0x007E/dir/pcb/DIR.kicad_pcb

## KiCad design pcb/DIR.kicad_pcb (2026-03-28)

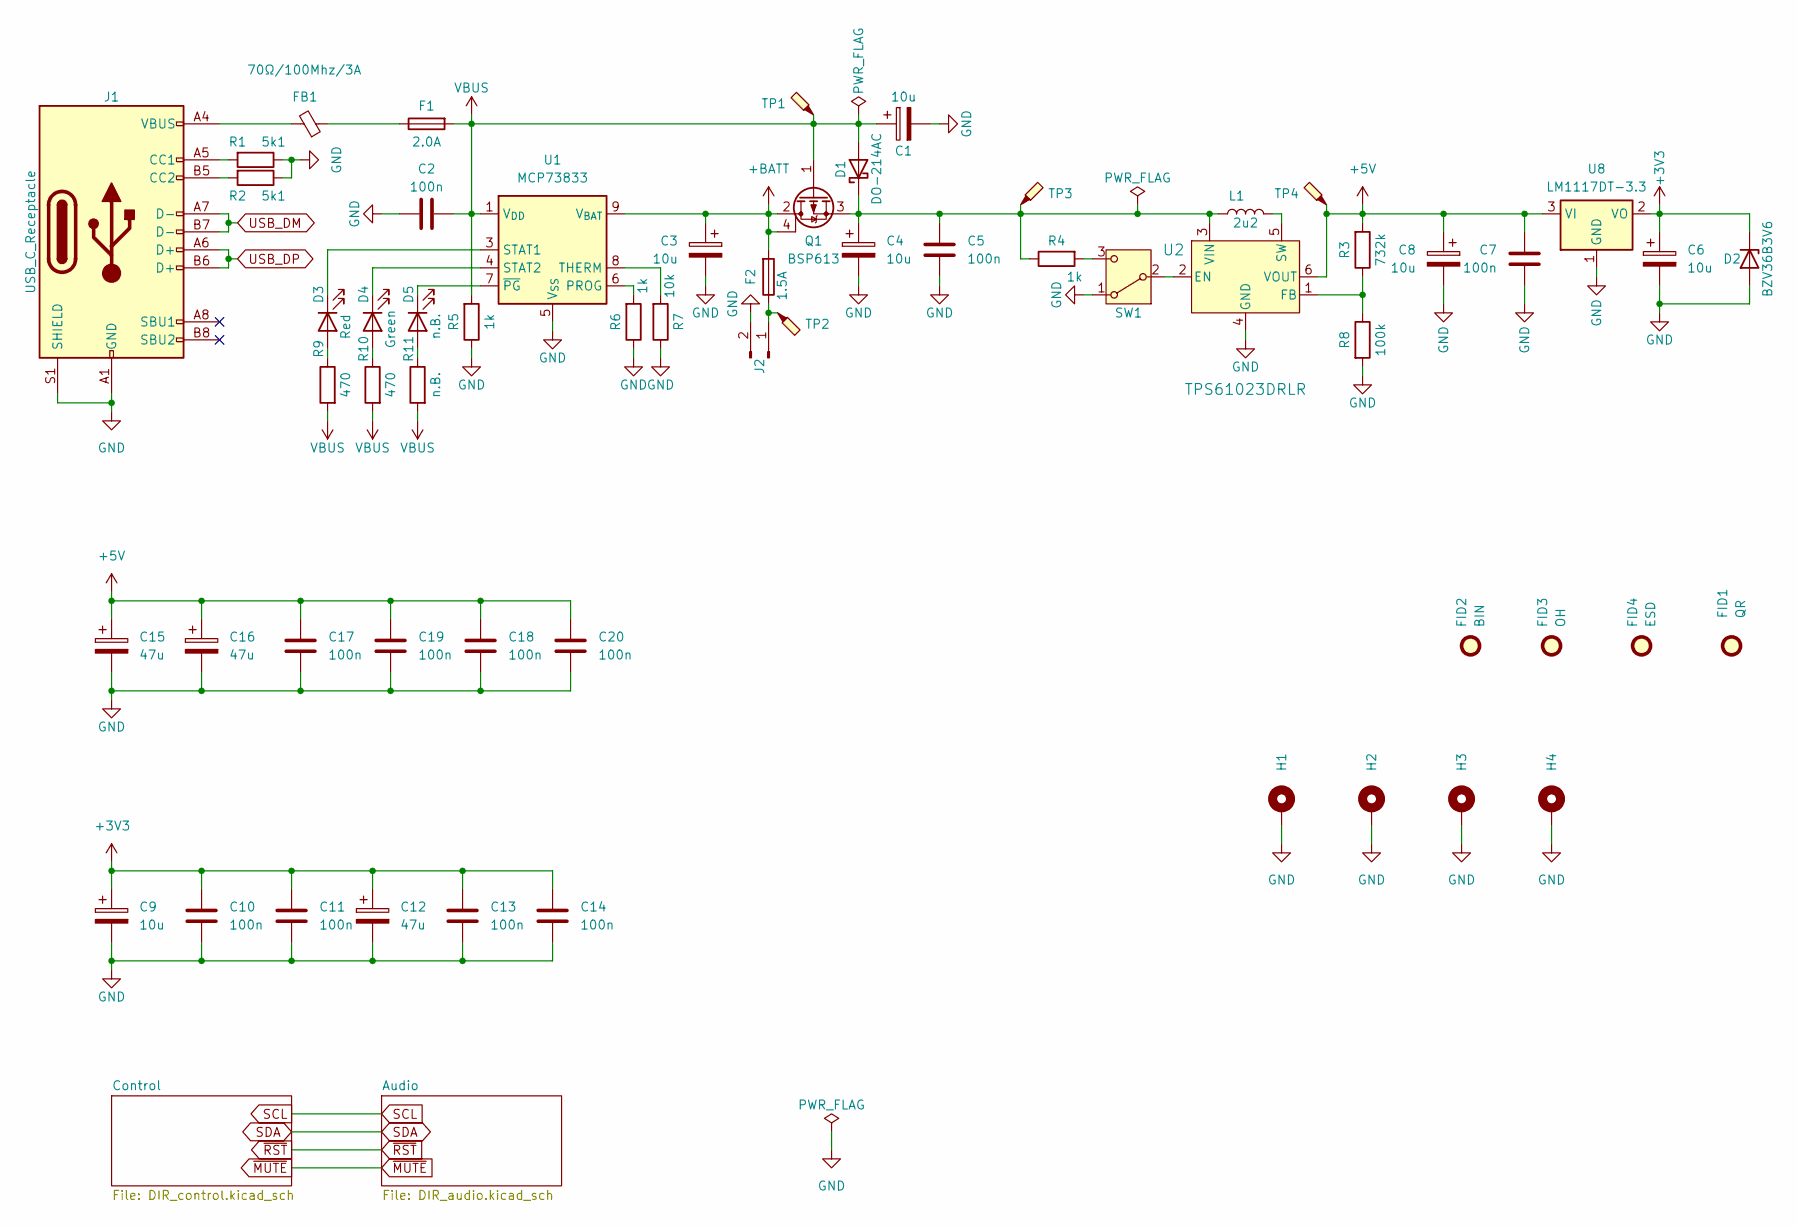
[picture p1: schematic DIR.kicad_sch, ${acronym} - ${title}]

Parts:
C1, C3, C4, C6, C8, C9: 10u; CP_EIA-6032-28_Kemet-C
C2, C5, C7, C10, C11, C13, C14, C17, C18, C19, C20: 100n; C_1206_3216Metric
C12, C15, C16: 47u; CP_EIA-6032-28_Kemet-C
D1: DO-214AC; D_SMA
D2: BZV36B3V6; D_MiniMELF
D3: Red; LED_1206_3216Metric
D4: Green; LED_1206_3216Metric
D5: n.B.; LED_1206_3216Metric
F1: 2.0A; Fuse_1206_3216Metric
F2: 1.5A; Fuse_1206_3216Metric
FB1: 70Ω/100Mhz/3A; L_1206_3216Metric
FID1: QR; QR_0x007e_very_small
FID2: BIN; WEEE-Logo_4.2x6mm_SilkScreen
FID3: OH; OSHW-Logo2_7.3x6mm_SilkScreen
FID4: ESD; ESD-Logo_6.6x6mm_SilkScreen
H1, H2: MountingHole_Pad; MountingHole_3.2mm_M3_DIN965_Pad
H3, H4: MountingHole_Pad; MountingHole_2.2mm_M2_Pad
J1: USB_C_Receptacle; USB_C_Receptacle_GCT_USB4110
J2: Conn_01x02_Pin; JST_PH_S2B-PH-K_1x02_P2.00mm_Horizontal
L1: 2u2; L_Vishay_IFSC-1515AH_4x4x1.8mm
Q1: BSP613; SOT-223
R1, R2: 5k1; R_1206_3216Metric
R3: 732k; R_1206_3216Metric
R4, R5, R6: 1k; R_1206_3216Metric
R7: 10k; R_1206_3216Metric
R8: 100k; R_1206_3216Metric
R9, R10: 470; R_1206_3216Metric
R11: n.B.; R_1206_3216Metric
SW1: SW_SPDT; SW_SPDT_CK_JS102011SAQN
TP1, TP2, TP3, TP4: TestPoint_Probe; TestPoint_Pad_D1.0mm
U1: MCP73833; MSOP-10_3x3mm_P0.5mm
U2: TPS61023DRLR; SOT-563
U8: LM1117DT-3.3; TO-252-3_TabPin2

Connections:
+3V3: C6.1, C9.1, C10.1, C11.1, C12.1, C13.1, C14.1, D2.1 (K), U8.2 (VO); also elsewhere on the board
+5V: C7.1, C8.1, C15.1, C16.1, C17.1, C18.1, C19.1, C20.1, R3.2, TP4.1, U2.6 (VOUT), U8.3 (VI); also elsewhere on the board
+BATT: C3.1, F2.2, Q1.2 (D), Q1.4 (D), U1.9 (V_{BAT}), U1.10 (V_{BAT})
GND: C1.2, C2.2, C3.2, C4.2, C5.2, C6.2, C7.2, C8.2, C9.2, C10.2, C11.2, C12.2, C13.2, C14.2, C15.2, C16.2, C17.2, C18.2, C19.2, C20.2, D2.2 (A), H1.1, H2.1, H3.1, H4.1, J1.A1 (GND), J1.A12 (GND), J1.B1 (GND), J1.B12 (GND), J1.S1 (SHIELD), J2.2, R1.1, R2.1, R5.1, R6.1, R7.1, R8.2, SW1.1 (A), U1.5 (V_{SS}), U2.4 (GND), U8.1 (GND); also elsewhere on the board
unnamed: C4.1, C5.1, D1.1 (K), L1.1, Q1.3 (S), R4.1, TP3.1, U2.3 (VIN)
unnamed: D3.2 (A), R9.1
unnamed: D3.1 (K), U1.3 (STAT1)
unnamed: D4.2 (A), R10.1
unnamed: D4.1 (K), U1.4 (STAT2)
unnamed: D5.2 (A), R11.1
unnamed: D5.1 (K), U1.7 (~PG)
unnamed: F1.1, FB1.1
unnamed: FB1.2, J1.A4 (VBUS), J1.A9 (VBUS), J1.B4 (VBUS), J1.B9 (VBUS)
unnamed: J1.A5 (CC1), R1.2
unnamed: J1.B5 (CC2), R2.2
unnamed: F2.1, J2.1, TP2.1
unnamed: SW1.2 (B), U2.2 (EN)
unnamed: R4.2, SW1.3 (C)
unnamed: R6.2, U1.6 (PROG)
unnamed: R7.2, U1.8 (THERM)
unnamed: R3.1, R8.1, U2.1 (FB)
unnamed: L1.2, U2.5 (SW)
USB_DM: J1.A7 (D-), J1.B7 (D-); also elsewhere on the board
USB_DP: J1.A6 (D+), J1.B6 (D+); also elsewhere on the board
VBUS: C1.1, C2.1, D1.2 (A), F1.2, Q1.1 (G), R5.2, R9.2, R10.2, R11.2, TP1.1, U1.1 (V_{DD}), U1.2 (V_{DD}); also elsewhere on the board

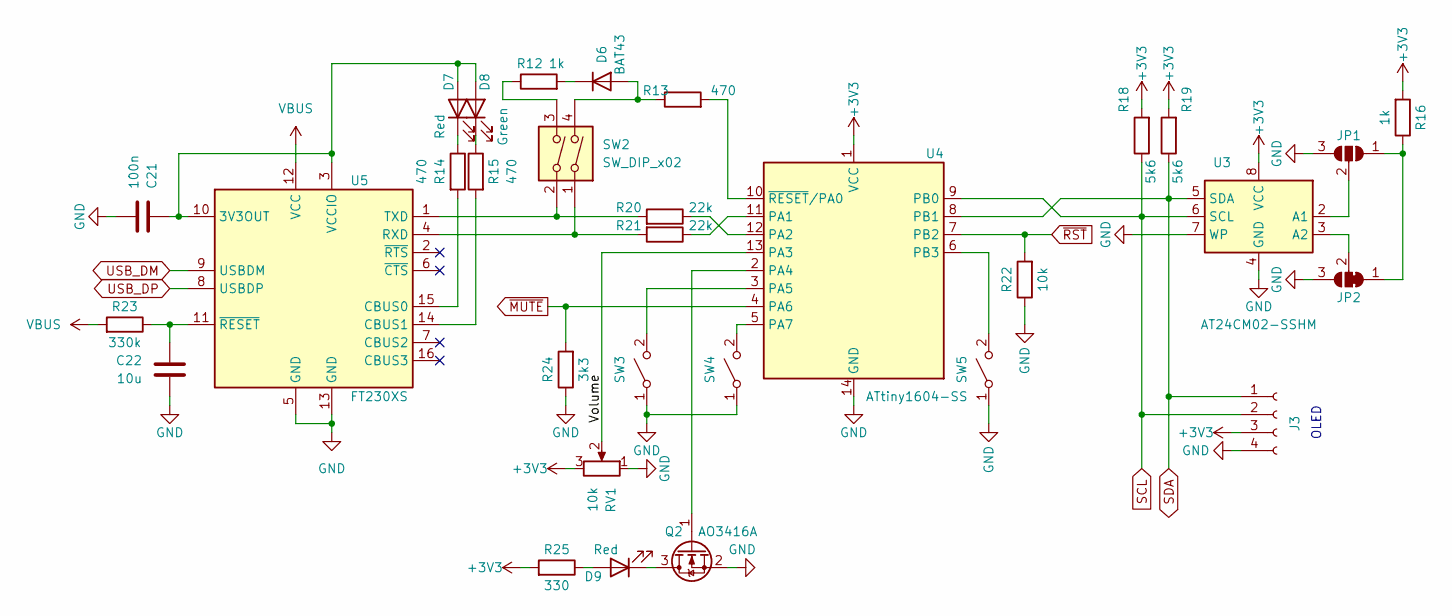
[picture p2: schematic DIR_control.kicad_sch, ${acronym} - ${title}]

Parts:
C21: 100n; C_1206_3216Metric
C22: 10u; C_1206_3216Metric
D6: BAT43; D_MiniMELF
D7, D9: Red; LED_1206_3216Metric
D8: Green; LED_1206_3216Metric
J3: Conn_01x04_Socket; PinSocket_1x04_P2.54mm_Vertical
JP1: SolderJumper_3_Open; SolderJumper-3_P1.3mm_Open_RoundedPad1.0x1.5mm_NumberLabels
JP2: SolderJumper_3_Bridged12; SolderJumper-3_P1.3mm_Bridged12_RoundedPad1.0x1.5mm_NumberL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
Q2: AO3416A; SOT-23
R12, R16: 1k; R_1206_3216Metric
R13, R14, R15: 470; R_1206_3216Metric
R18, R19: 5k6; R_1206_3216Metric
R20, R21: 22k; R_1206_3216Metric
R22: 10k; R_1206_3216Metric
R23: 330k; R_1206_3216Metric
R24: 3k3; R_1206_3216Metric
R25: 330; R_1206_3216Metric
RV1: 10k; Potentiometer_Piher_PT-10-V10_Vertical
SW2: SW_DIP_x02; SW_DIP_SPSTx02_Slide_6.7x6.64mm_W8.61mm_P2.54mm_LowProfile
SW3, SW4, SW5: SW_SPST; SW_Tactile_SPST_Angled_PTS645Vx58-2LFS
U3: AT24CM02-SSHM; SOIC-8_3.9x4.9mm_P1.27mm
U4: ATtiny1604-SS; SOIC-14_3.9x8.7mm_P1.27mm
U5: FT230XS; SSOP-16_3.9x4.9mm_P0.635mm

Connections:
+3V3: J3.3, R16.2, R18.2, R19.2, R25.2, RV1.3, U3.8 (VCC), U4.1 (VCC); also elsewhere on the board
/Control/Volume: RV1.2, U4.13 (PA3)
GND: C21.1, C22.2, J3.4, JP1.3 (B), JP2.3 (B), Q2.2 (S), R22.1, R24.1, RV1.1, SW3.1 (A), SW4.1 (A), SW5.1 (A), U3.4 (GND), U3.7 (WP), U4.14 (GND), U5.5 (GND), U5.13 (GND); also elsewhere on the board
unnamed: D6.2 (A), R13.1, SW2.4
unnamed: D6.1 (K), R12.2
unnamed: C21.2, D7.2 (A), D8.2 (A), U5.3 (VCCIO), U5.10 (3V3OUT)
unnamed: D7.1 (K), R14.1
unnamed: D8.1 (K), R15.1
unnamed: D9.2 (A), R25.1
unnamed: D9.1 (K), Q2.3 (D)
unnamed: JP1.1 (A), JP2.1 (A), R16.1
unnamed: JP1.2 (C), U3.2 (A1)
unnamed: JP2.2 (C), U3.3 (A2)
unnamed: Q2.1 (G), U4.2 (PA4)
unnamed: R12.1, SW2.3
unnamed: SW3.2 (B), U4.3 (PA5)
unnamed: SW4.2 (B), U4.5 (PA7)
unnamed: SW5.2 (B), U4.6 (PB3)
unnamed: R21.1, U4.11 (PA1)
unnamed: R20.1, U4.12 (PA2)
unnamed: R13.2, U4.10 (~RESET/PA0)
unnamed: R14.2, U5.15 (CBUS0)
unnamed: R15.2, U5.14 (CBUS1)
unnamed: R21.2, SW2.1, U5.4 (RXD)
unnamed: R20.2, SW2.2, U5.1 (TXD)
unnamed: C22.1, R23.1, U5.11 (~RESET)
SCL: J3.2, R18.1, U3.6 (SCL), U4.9 (PB0); also elsewhere on the board
SDA: J3.1, R19.1, U3.5 (SDA), U4.8 (PB1); also elsewhere on the board
USB_DM: U5.9 (USBDM); also elsewhere on the board
USB_DP: U5.8 (USBDP); also elsewhere on the board
VBUS: R23.2, U5.12 (VCC); also elsewhere on the board
~MUTE: R24.2, U4.4 (PA6); also elsewhere on the board
~RST: R22.2, U4.7 (PB2); also elsewhere on the board

Notes on the sheet:
OLED

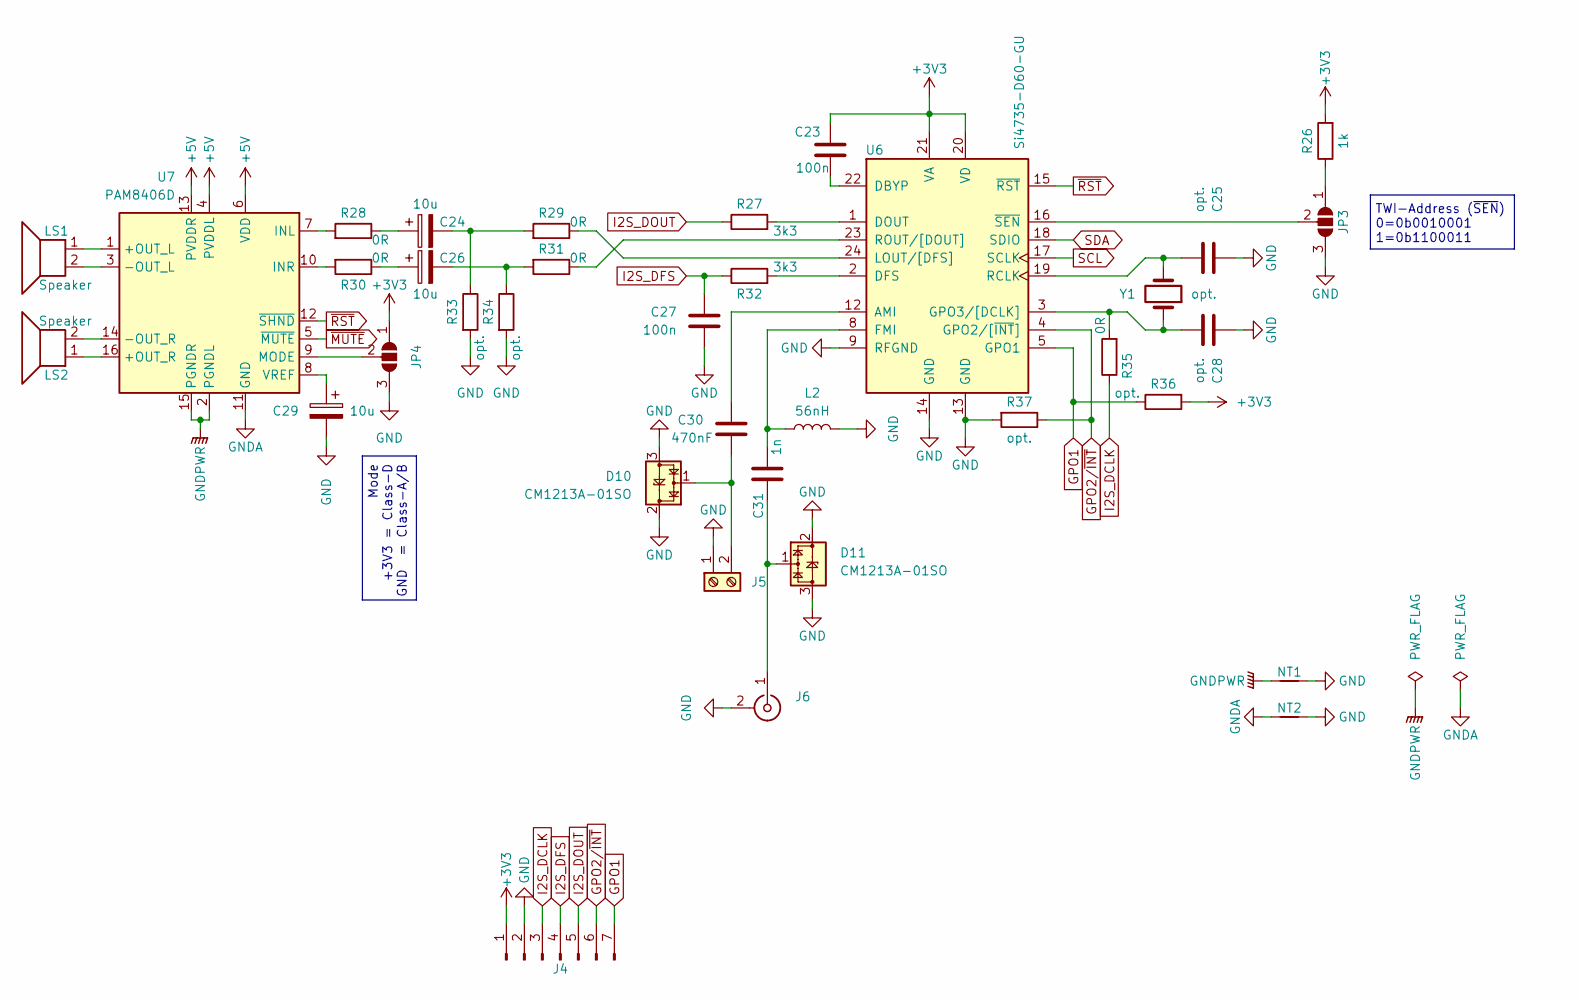
[picture p3: schematic DIR_audio.kicad_sch, ${acronym} - ${title}]

Parts:
C23, C27: 100n; C_1206_3216Metric
C24, C26, C29: 10u; CP_Elec_5x5.3
C25, C28: opt.; C_0603_1608Metric
C30: 470nF; C_0603_1608Metric
C31: 1n; C_0603_1608Metric
D10, D11: CM1213A-01SO; SOT-23
J4: Conn_01x07_Pin; PinSocket_1x07_P2.54mm_Horizontal
J5: Screw_Terminal_01x02; WAGO_2060-402_998-404
J6: Conn_Coaxial; SMA_Amphenol_901-143_Horizontal
JP3, JP4: SolderJumper_3_Open; SolderJumper-3_P1.3mm_Open_RoundedPad1.0x1.5mm_NumberLabels
L2: 56nH; L_0603_1608Metric
LS1, LS2: Speaker; WAGO_2060-402_998-404
NT1, NT2: NetTie_2; NetTie-2_SMD_Pad0.5mm
R26: 1k; R_1206_3216Metric
R27, R32: 3k3; R_1206_3216Metric
R28, R29, R30, R31, R35: 0R; R_1206_3216Metric
R33, R34, R36, R37: opt.; R_1206_3216Metric
U6: Si4735-D60-GU; SSOP-24_3.9x8.7mm_P0.635mm
U7: PAM8406D; SOIC-16_3.9x9.9mm_P1.27mm
Y1: opt.; Crystal_SMD_3215-2Pin_3.2x1.5mm

Connections:
+3V3: C23.1, J4.1, JP4.1 (A), R26.2, R36.2, U6.20 (VD), U6.21 (VA); also elsewhere on the board
+5V: U7.4 (PVDDL), U7.6 (VDD), U7.13 (PVDDR); also elsewhere on the board
GND: C25.1, C27.2, C28.1, C29.2, D10.2 (VP), D10.3 (VN), D11.2 (VP), D11.3 (VN), J4.2, J5.1, J6.2 (Ext), JP3.3 (B), JP4.3 (B), L2.2, NT1.2, NT2.2, R33.2, R34.2, R37.2, U6.9 (RFGND), U6.13 (GND), U6.14 (GND); also elsewhere on the board
GNDA: NT2.1, U7.11 (GND)
GNDPWR: NT1.1, U7.2 (PGNDL), U7.15 (PGNDR)
GPO1: J4.7, R36.1, U6.5 (GPO1)
GPO2/~INT: J4.6, R37.1, U6.4 (GPO2/[~INT])
I2S_DCLK: J4.3, R35.1
I2S_DFS: C27.1, J4.4, R32.1
I2S_DOUT: J4.5, R27.1
unnamed: C24.1, R28.1
unnamed: C24.2, R29.2, R33.1
unnamed: C26.1, R30.1
unnamed: C26.2, R31.2, R34.1
unnamed: C30.2, D10.1 (CH1), J5.2
unnamed: C31.1, D11.1 (CH1), J6.1 (In)
unnamed: JP3.1 (A), R26.1
unnamed: JP3.2 (C), U6.16 (~SEN)
unnamed: JP4.2 (C), U7.9 (MODE)
unnamed: C30.1, U6.12 (AMI)
unnamed: C23.2, U6.22 (DBYP)
unnamed: R32.2, U6.2 (DFS)
unnamed: R27.2, U6.1 (DOUT)
unnamed: C31.2, L2.1, U6.8 (FMI)
unnamed: C28.2, R35.2, U6.3 (GPO3/[DCLK]), Y1.1
unnamed: R29.1, U6.24 (LOUT/[DFS])
unnamed: C25.2, U6.19 (RCLK), Y1.2
unnamed: R31.1, U6.23 (ROUT/[DOUT])
unnamed: LS1.1, U7.1 (+OUT_L)
unnamed: LS2.1, U7.16 (+OUT_R)
unnamed: LS1.2, U7.3 (-OUT_L)
unnamed: LS2.2, U7.14 (-OUT_R)
unnamed: R28.2, U7.7 (INL)
unnamed: R30.2, U7.10 (INR)
unnamed: C29.1, U7.8 (VREF)
SCL: U6.17 (SCLK); also elsewhere on the board
SDA: U6.18 (SDIO); also elsewhere on the board
~MUTE: U7.5 (~MUTE); also elsewhere on the board
~RST: U6.15 (~RST), U7.12 (~SHND); also elsewhere on the board

Notes on the sheet:
Mode +3V3 = Class-D GND = Class-A/B
TWI-Address (~{SEN}) 0=0b0010001 1=0b1100011

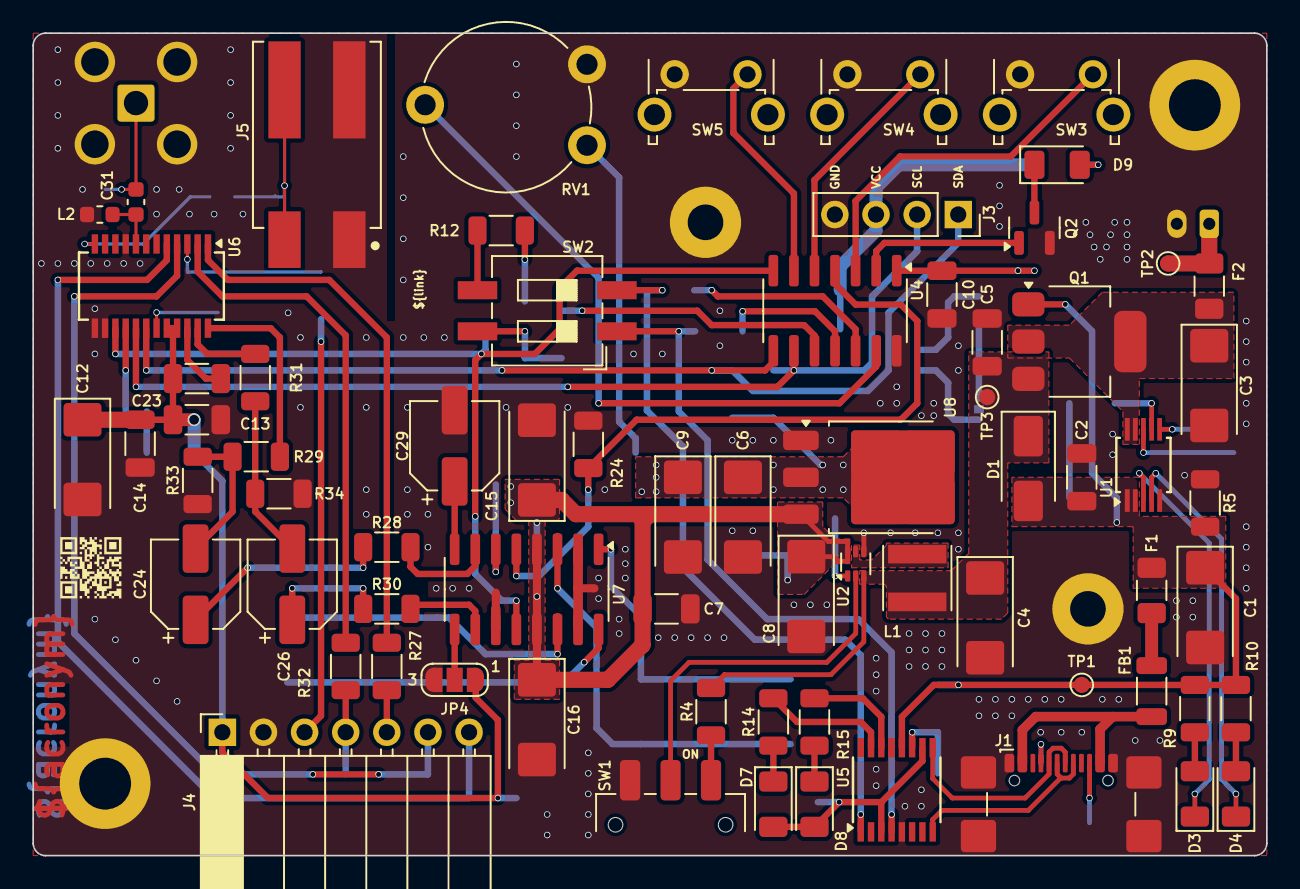
[picture p4: board DIR.kicad_pcb from above]

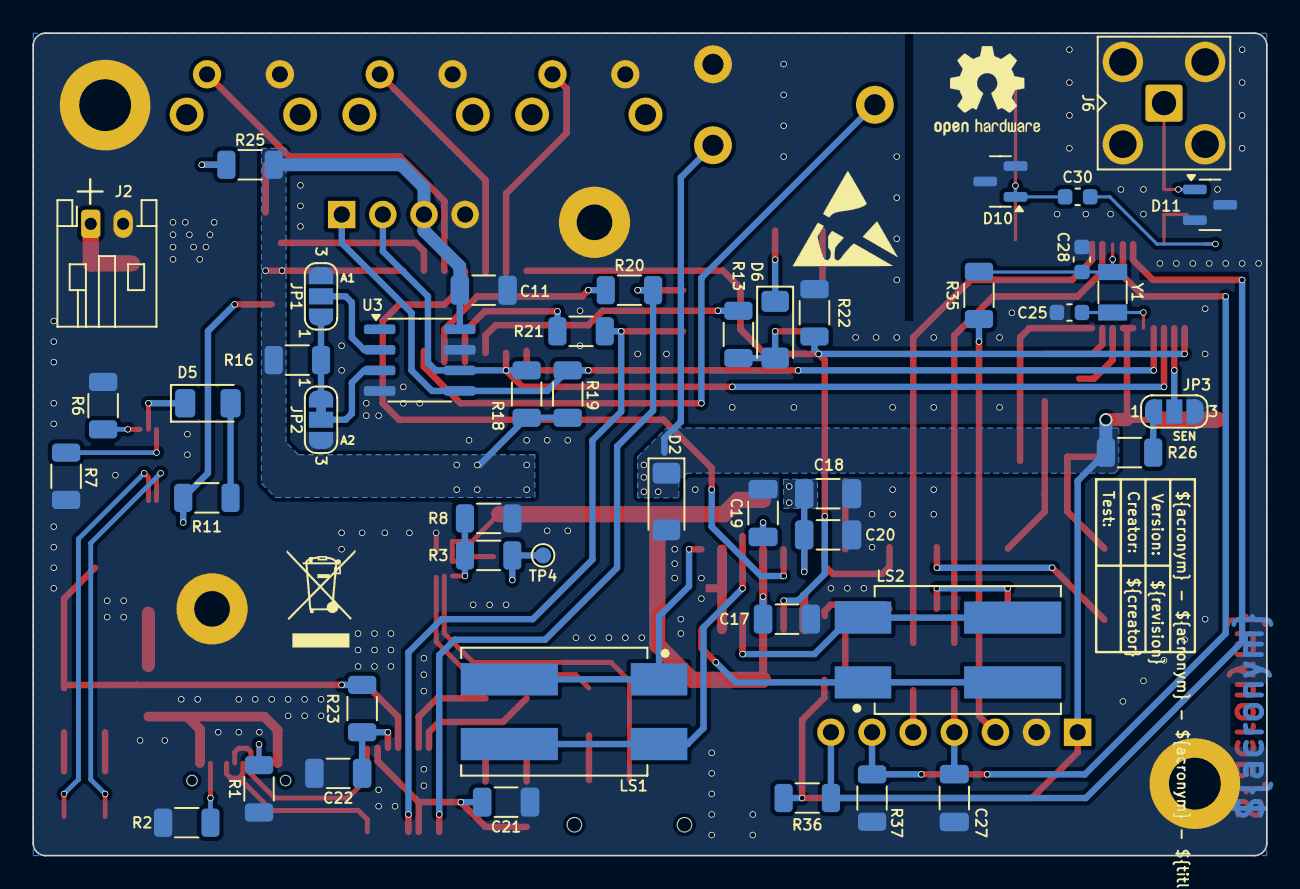
[picture p5: board DIR.kicad_pcb from below]

Board: 2 copper layers, 76.2 x 50.8 mm, 126 parts (49 on the bottom side), 85 nets.
