0x007E/dir/(commit log)

2026-02-18 Add pcb layout
    [DIR.kicad_pcb, DIR.kicad_sch, DIR_audio.kicad_sch, DIR_control.kicad_sch]
2026-03-18 Add missing vendor
    [DIR.kicad_pcb, DIR_audio.kicad_sch]
2026-03-18 Fix silkscreen position
    [DIR.kicad_pcb]
2026-03-18 Remove optional vendors
    [DIR.kicad_pcb, DIR_audio.kicad_sch]
2026-03-25 Fix wrong vendor-id
    [DIR.kicad_pcb, DIR.kicad_sch, DIR_audio.kicad_sch]
2026-03-25 Repositioning of overlapping reference and value
    [DIR_control.kicad_sch]
2026-03-26 Fix TWI address description
    [DIR_audio.kicad_sch]
2026-03-27 Change Z-Diode to 3V3
    [DIR.kicad_pcb, DIR.kicad_sch, DIR_control.kicad_sch]
2026-03-27 Fix power path issue
    [DIR.kicad_pcb, DIR.kicad_sch, DIR_audio.kicad_sch]
2026-03-27 Change SHDN and MUTE pins
    [DIR.kicad_pcb, DIR_audio.kicad_sch]
2026-03-27 Modify pcb position
    [DIR.kicad_pcb]
2026-03-28 Fix 3d oled rotation
    [DIR.kicad_pcb]
2026-03-28 Add dimensioning
    [DIR.kicad_pcb]
2026-03-30 Add buttons and switch
2026-03-30 Change env variables to upper case
2026-04-15 Optimize push-button position
